alexandergillon/SST39SF-programmer/arduino/state-diagram.png

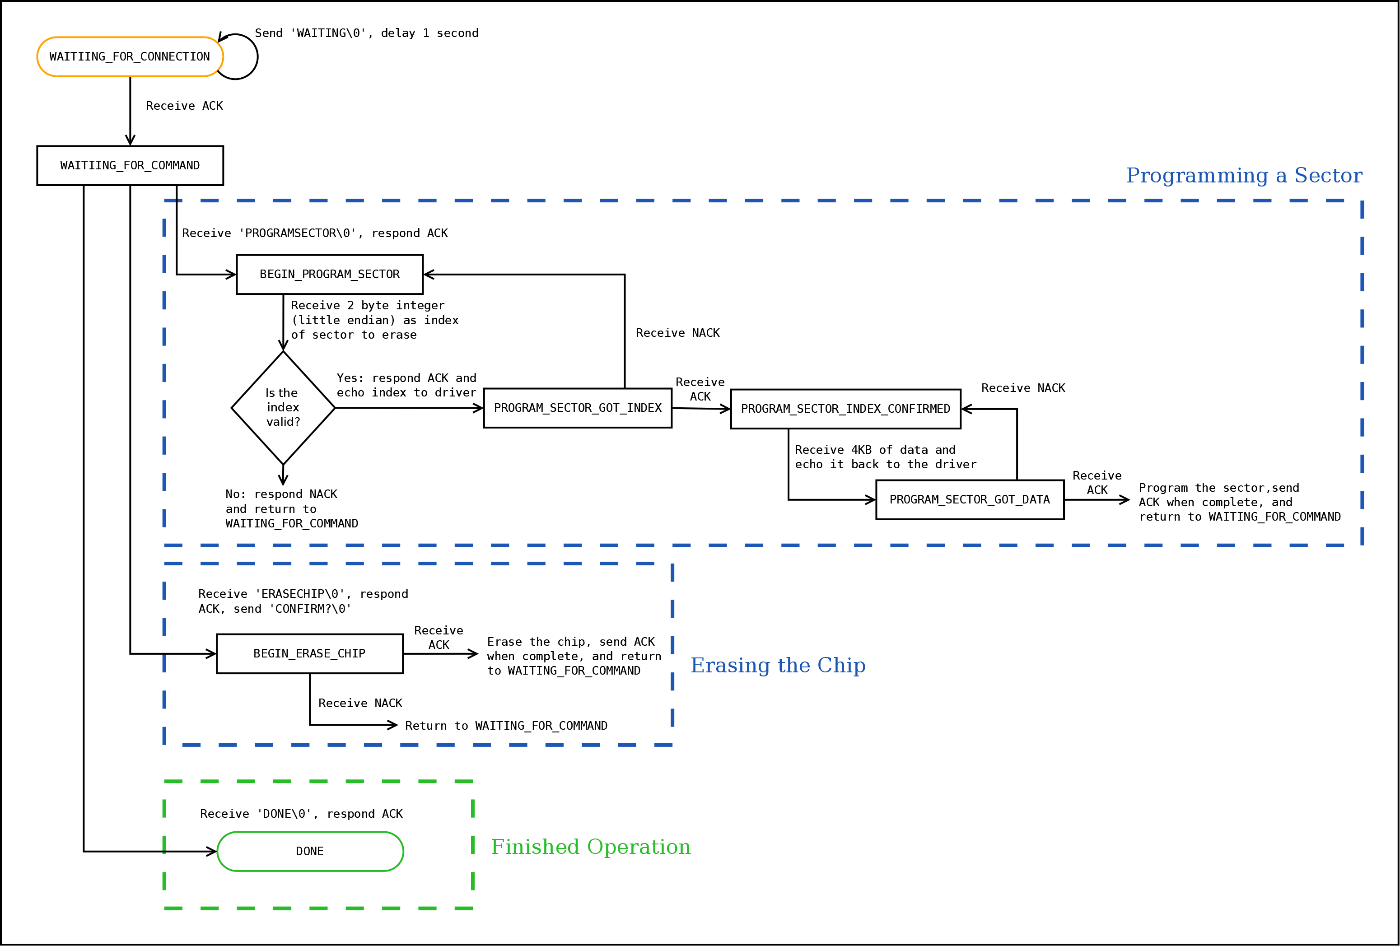
arduino/state-diagram.png
