alexandergillon/SST39SF-programmer/arduino/SST39SF-programmer/constants.h

#define DEBUG

#define SERIAL_BAUD_RATE 9600

//=============================================================================
//  Pinout: change these if you are wiring the Arduino differently
//=============================================================================

#define WRITE_ENABLE 2           // Write enable pin, active low
#define OUTPUT_ENABLE 3          // Output enable pin, active low
#define ADDR0 22                 // Starting pin of the address bus: pins count up from here
#define DQ0 44                   // Starting pin of the data bus: pins count up from here


//=============================================================================
//  Chip constants: change these if you are using a different size chip
//=============================================================================
//
//            Chip          Address Bus Length          Flash Size         
// 
//         SST39SF010              17                     131072
//         SST39SF020              18                     262144
//         SST39SF040              19                     524288
//
//=============================================================================

#define ADDRESS_BUS_LENGTH 18    // Length of the address bus: depends on chip size
#define DATA_BUS_LENGTH 8        // Length of the data bus: always 8 bits
#define SST_FLASH_SIZE 262144    // Number of bytes of flash on the chip: depends on chip size
#define SST_SECTOR_SIZE 4096     // Number of bytes in a sector: always 4096 bytes
#define SST_NUMBER_SECTORS (SST_FLASH_SIZE / SST_SECTOR_SIZE)  
