alexandergillon/SST39SF-programmer/arduino/SST39SF-programmer/read_write.h

/*
 * Functionality that handles reading from / writing to the SST39SF chip.
 * 
 * Copyright (C) 2023 Alexander Gillon
 * 
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
 * You should have received a copy of the GNU General Public License
 * along with this program.  If not, see <https://www.gnu.org/licenses/>.
 */
#ifndef SST39SF_PROGRAMMER_READ_WRITE_H
#define SST39SF_PROGRAMMER_READ_WRITE_H

#include <Arduino.h>

//=============================================================================
//             PIN CONFIGURATION
//=============================================================================

/** @brief Sets the control pins (WRITE_ENABLE) and (OUTPUT_ENABLE) to disabled. */
void setupControlPins();
/** @brief Sets the address pins to output mode, and clears them. */
void setupAddressPins();
/** @brief Sets the data pins to input mode. */
void setDataPinsIn();
/** @brief Sets the data pins to output mode. */
void setDataPinsOut();

//=============================================================================
//             READING/WRITING DATA
//=============================================================================

/**
 * @brief Reads a byte from the SST39SF at a specific address. Requires the data pins to be set to input.
 * 
 * Fails if compiled with DEBUG defined and the data pins are not set to input.
 * 
 * @param address the address to read from
 * @return byte the data at that address
 */
byte readByte(uint32_t address);

/**
 * @brief Writes a byte to an address. Requires the data pins to be set to output.
 * 
 * NOTE: this function writes to the SST39SF via the required command sequence, as defined in the datasheet.
 * 
 * Fails if compiled with DEBUG defined and the data pins are not set to output.
 * 
 * @param address the address to write to
 * @param data the data to write
 */
void writeByte(uint32_t address, byte data);

//=============================================================================
//             ERASING DATA
//=============================================================================

/**
 * @brief Erases a sector starting at a certain memory address. Requires the data pins to be set to output.
 * 
 * NOTE: addresses that do not correspond to the start of a sector will not fail, and will likely have
 * unintended results. The SST39SF uses the most significant bits of the address bus to select which 
 * sector to erase: passing in an address that is not the start of a sector will likely cause the sector
 * in which that address is contained to be erased, as the lower bits would be ignored 
 * (however no guarantees are made). 
 * 
 * NOTE: addresses are not bounds checked. Using values larger than the addressable memory on the chip
 * will have unintended results, likely erasing the sector that is the same moduluo the size of the
 * address space (however no guarantees are made). 
 * 
 * If compiled with the DEBUG flag:
 *   - Input validation of the address will occur, and the operation will instead fail if the address 
 *     could not be the start of a sector or if the starting address is out of range.
 *   - Fails if the data pins are not set to output.
 * 
 * @param address the starting address of a sector
 */
void eraseSectorStartingAt(uint32_t address);

/**
 * @brief Erases the nth sector of the SST39SF (zero-indexed). Requires the data pins to be set to output.
 * 
 * I.e. eraseSector(0) erases the first sector, eraseSector(1) erases the second, etc.
 * 
 * NOTE: the sector index is not bounds checked. Using values larger than the number of sectors will
 * have unintended results, likely erasing the sector that is the same moduluo the number of sectors
 * (however no guarantees are made). 
 * 
 * If compiled with the DEBUG flag:
 *   - The sector index is instead bounds checked, and the operation will fail if the sector index is out
 *     of bounds.
 *   - Fails if the data pins are not set to output.
 * 
 * @param sectorIndex the index of the sector to erase (zero-indexed)
 */
void eraseSector(uint16_t sectorIndex);

/**
 * @brief Erases the SST39SF chip. Requires the data pins to be set to output.
 * 
 * Fails if compiled with DEBUG defined and the data pins are not set to output.
 * 
 */
void eraseChip();

#endif  // SST39SF_PROGRAMMER_READ_WRITE_H
