alexandergillon/SST39SF-programmer/(commit log)

2023-05-30 Creates ArduinoDriver.cs, a small C# program that reads serial communication from the Arduino. Will later be expanded to drive the Arduino in writing the SST39SF chip.
2023-05-30 Moves Arduino code to a subdirectory.
2023-05-31 Moves Arduino code to a further subdirectory, as the directory containing the .ino file must have the same name as the .ino file itself. Implements sector erase opteration, and a small test program f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
2023-05-31 Creates a communication specification in comm-spec.md. Refactors constants.h into two new files: sst_constants.h (for constants related to the SST chip), and pinout.h (for constants relating to the A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
2023-05-31 Fixes oversight in last commit where communication from Arduino is not checked to be correct.
2023-06-01 Updates Arduino driver to be more fault tolerant and informative, and moves some code into new functions.
2023-06-02 Creates Arduino.cs, which wraps SerialPort with some utility functionality. Refactors ArduinoDriver.cs somewhat to improve style.
2023-06-04 Implements sector programming on the Arduino, controllable by the driver. Writes a driver program to write a binary file to the SST39SF.
    This commit contains a lot of changes:
    1. Deletes the old communication specification. The specification was
    wordy and awkward, and the ideas contained within could be much
    better explained by a diagram (even if this is technically slightly
    less precise). The Arduino essentially now functions as a state
    machine: certain actions from the driver cause the Arduino to do
    certain things. This makes the Arduino easier to reason about. The
    diagram which govern's the Arduino's behavior is in the newly created
    arduino/state-diagram.png file, wh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
2023-06-18 Code cleanup. Changes baud rate to 115200. Driver is in working state to program SST39SF via Arduino.
2023-06-21 Implements debug mode for the Arduino: on startup, if a certain pin is tied to ground, the Arduino will print out the full memory of the SST39SF chip which can be inspected for its contents.
2023-06-21 Implements arbitrary programming mode on the driver. This allows a file to be written to the SST39SF starting at an arbitrary location in memory. See ArbitraryProgramming.cs for more details.
2023-06-25 Rewrites Arduino sector programming code to be much cleaner and rely on much fewer global variables. Implements chip erase functionality in driver, and corresponding communication code in Arduino. Re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
2023-06-25 Adds 'DONE' communication sequence between driver and Arduino, for the driver to tell the Arduino when it is done.
2023-09-18 Adds circuit diagram.
